agausmann/riemann-kb/README.md

# Riemann

SN1

## Features

- 60% ortholinear
- "Pseudo-split", 3-column separation between halves
- 2x 7-segment indication with external constant-current LED driver and PWM
  dimming
- 3D-printed and laser-cut case files available

## Compatibility

- MX switches (no hotswap)
- (Optional) EC11 encoders in top-left and top-right corners
- Through-hole and SMD component footprints
- Runs on Raspberry Pi Pico (and my USB-C clone, [Piccolo])

[Piccolo]: https://github.com/agausmann/piccolo
