agausmann/riemann-kb/(threads)

Thread 1 (2022-10-30):

LEDs go to full brightness when MCU is reset.

agausmann, 2022-10-30:
This is because the nOE pin of the MAX6969 LED driver is floating on reset (may be internally pulled down by the IC). Adding a pull-up resistor to that pin should fix the issue.
