agausmann/riemann-kb/pcb/encoder_key.kicad_sch

## KiCad design pcb/encoder_key.kicad_sch (2023-07-13)

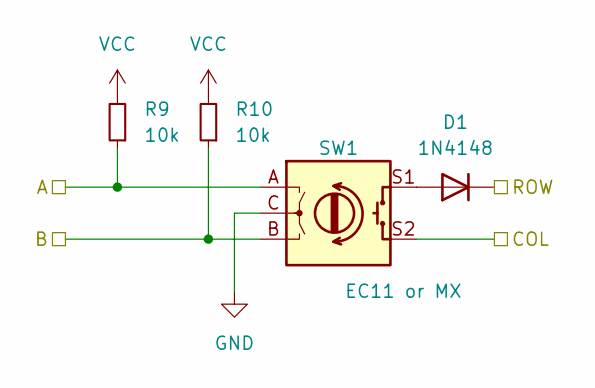
[picture p1: schematic encoder_key.kicad_sch]

Parts:
D1: 1N4148; D_DO-34_SOD68_P7.62mm_Horizontal
R9, R10: 10k; R_Axial_DIN0204_L3.6mm_D1.6mm_P7.62mm_Horizontal
SW1: EC11 or MX; Hybrid_EC11_or_MX

Connections:
A: R9.1, SW1.A
B: R10.1, SW1.B
COL: SW1.S2
GND: SW1.C
unnamed: D1.2 (A), SW1.S1
ROW: D1.1 (K)
VCC: R9.2, R10.2
