agausmann/riemann-kb/pcb/key.kicad_sch

## KiCad design pcb/key.kicad_sch (2023-07-13)

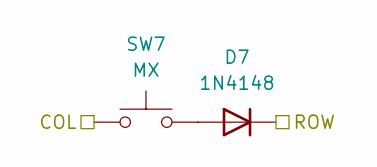
[picture p2: schematic key.kicad_sch]

Parts:
D7: 1N4148; D_DO-34_SOD68_P7.62mm_Horizontal
SW7: MX; SW_Cherry_MX_1.00u_PCB_ReCenter

Connections:
COL: SW7.2
unnamed: D7.2 (A), SW7.1
ROW: D7.1 (K)
