agausmann/riemann-kb/pcb/leds.kicad_sch

## KiCad design pcb/leds.kicad_sch (2023-07-13)

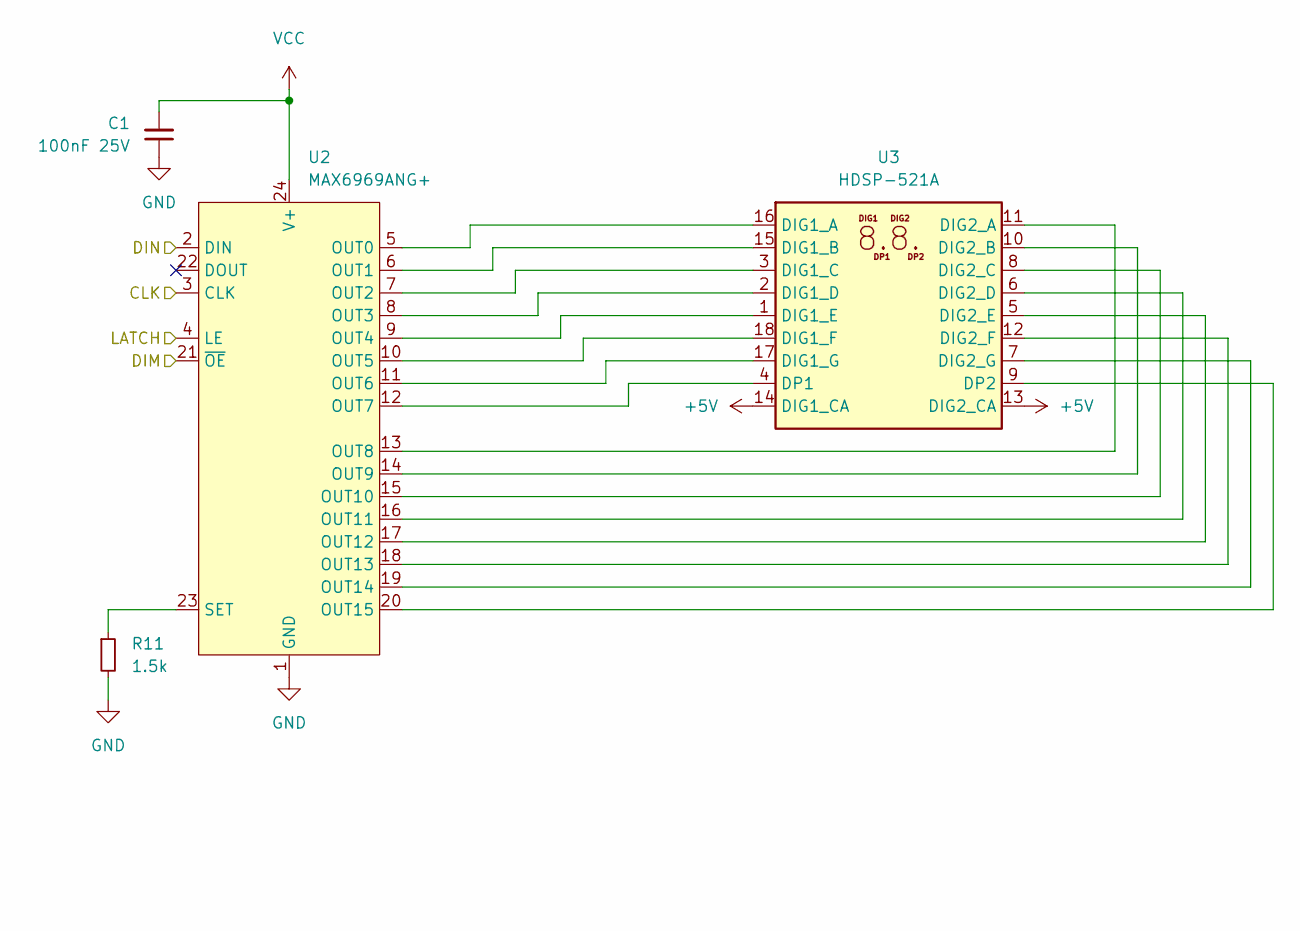
[picture p3: schematic leds.kicad_sch]

Parts:
C1: 100nF 25V; C_Disc_D5.0mm_W2.5mm_P2.50mm
R11: 1.5k; R_Axial_DIN0204_L3.6mm_D1.6mm_P7.62mm_Horizontal
U2: MAX6969ANG+; DIP-24_W7.62mm
U3: HDSP-521A; DA56-11SURKWA

Connections:
+5V: U3.13 (DIG2_CA), U3.14 (DIG1_CA)
CLK: U2.3 (CLK)
DIM: U2.21 (~OE)
DIN: U2.2 (DIN)
GND: C1.1, R11.2, U2.1 (GND)
LATCH: U2.4 (LE)
unnamed: R11.1, U2.23 (SET)
unnamed: U2.5 (OUT0), U3.16 (DIG1_A)
unnamed: U2.6 (OUT1), U3.15 (DIG1_B)
unnamed: U2.7 (OUT2), U3.3 (DIG1_C)
unnamed: U2.8 (OUT3), U3.2 (DIG1_D)
unnamed: U2.9 (OUT4), U3.1 (DIG1_E)
unnamed: U2.10 (OUT5), U3.18 (DIG1_F)
unnamed: U2.11 (OUT6), U3.17 (DIG1_G)
unnamed: U2.12 (OUT7), U3.4 (DP1)
unnamed: U2.13 (OUT8), U3.11 (DIG2_A)
unnamed: U2.14 (OUT9), U3.10 (DIG2_B)
unnamed: U2.15 (OUT10), U3.8 (DIG2_C)
unnamed: U2.16 (OUT11), U3.6 (DIG2_D)
unnamed: U2.17 (OUT12), U3.5 (DIG2_E)
unnamed: U2.18 (OUT13), U3.12 (DIG2_F)
unnamed: U2.19 (OUT14), U3.7 (DIG2_G)
unnamed: U2.20 (OUT15), U3.9 (DP2)
VCC: C1.2, U2.24 (V+)
