agausmann/riemann-kb/pcb/matrix.kicad_sch

## KiCad design pcb/matrix.kicad_sch (2023-07-13)

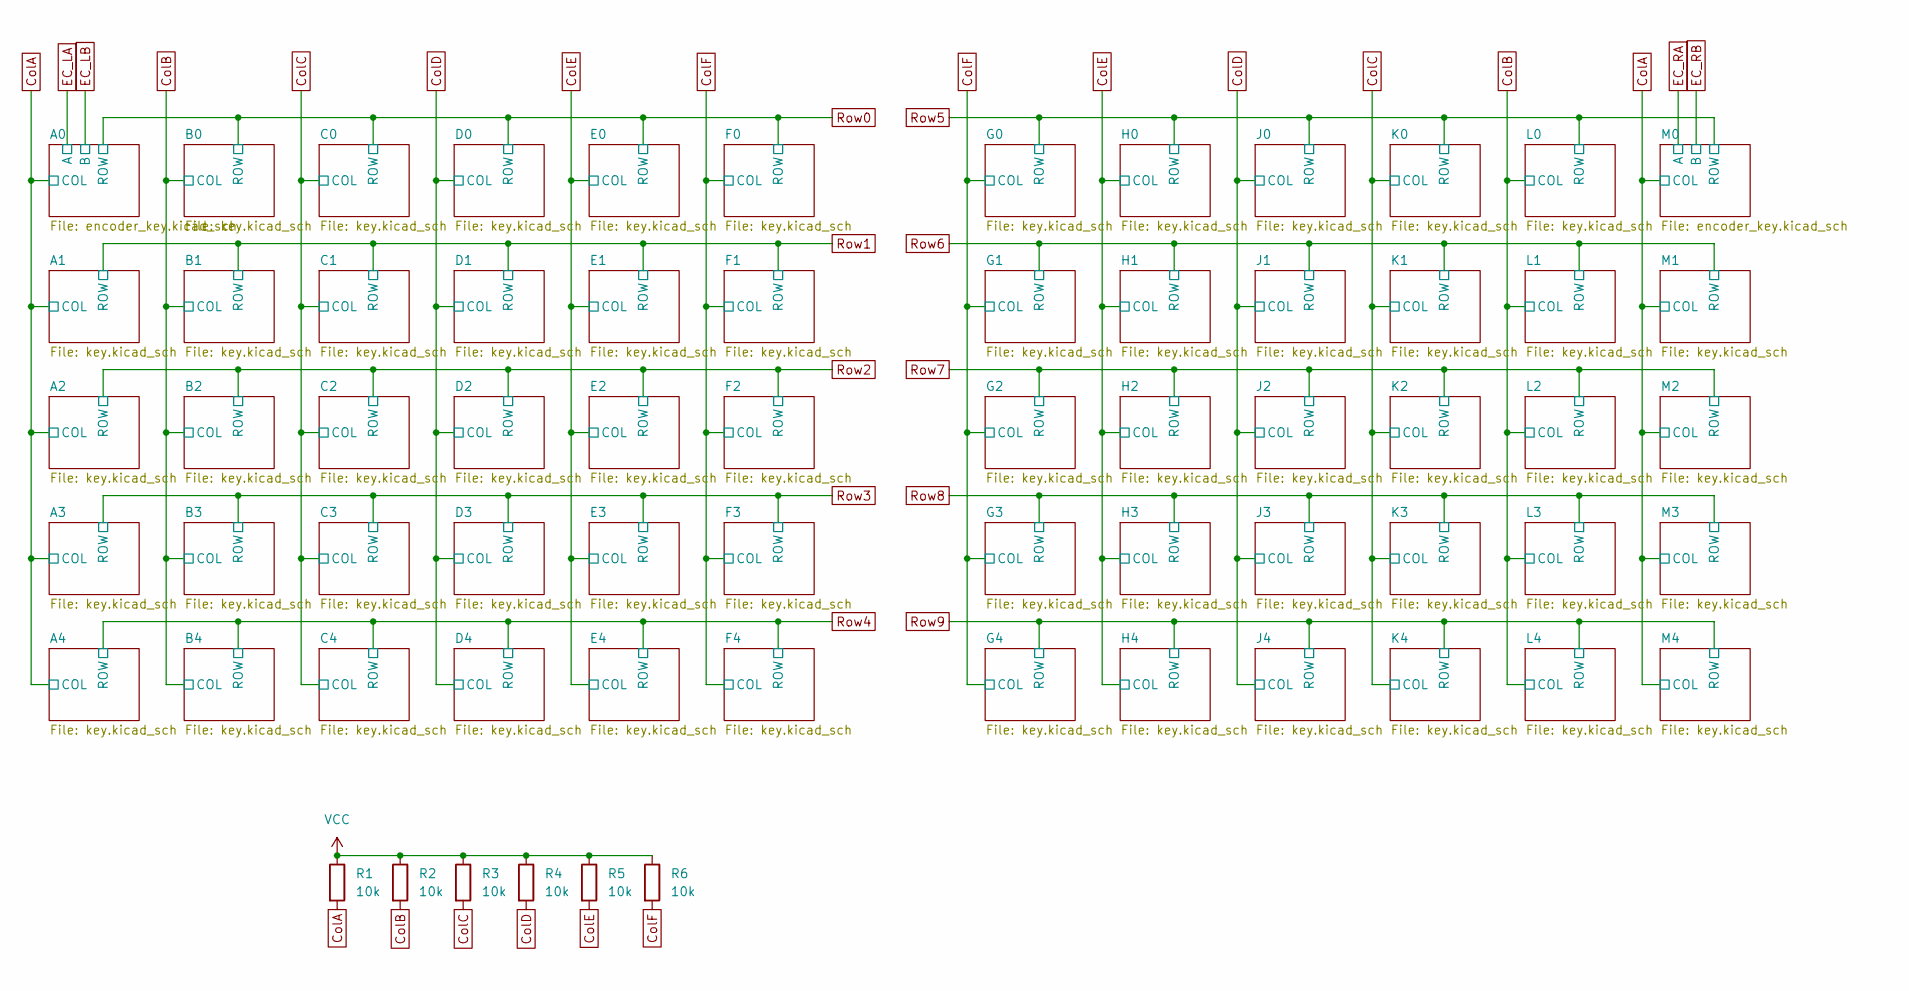
[picture p4: schematic matrix.kicad_sch]

Parts:
R1, R2, R3, R4, R5, R6: 10k; R_Axial_DIN0204_L3.6mm_D1.6mm_P7.62mm_Horizontal

Connections:
ColA: R1.2
ColB: R2.2
ColC: R3.2
ColD: R4.2
ColE: R5.2
ColF: R6.2
VCC: R1.1, R2.1, R3.1, R4.1, R5.1, R6.1
