agausmann/riemann-kb/pcb/riemann.kicad_sch

## KiCad design pcb/riemann.kicad_sch (2023-07-13)

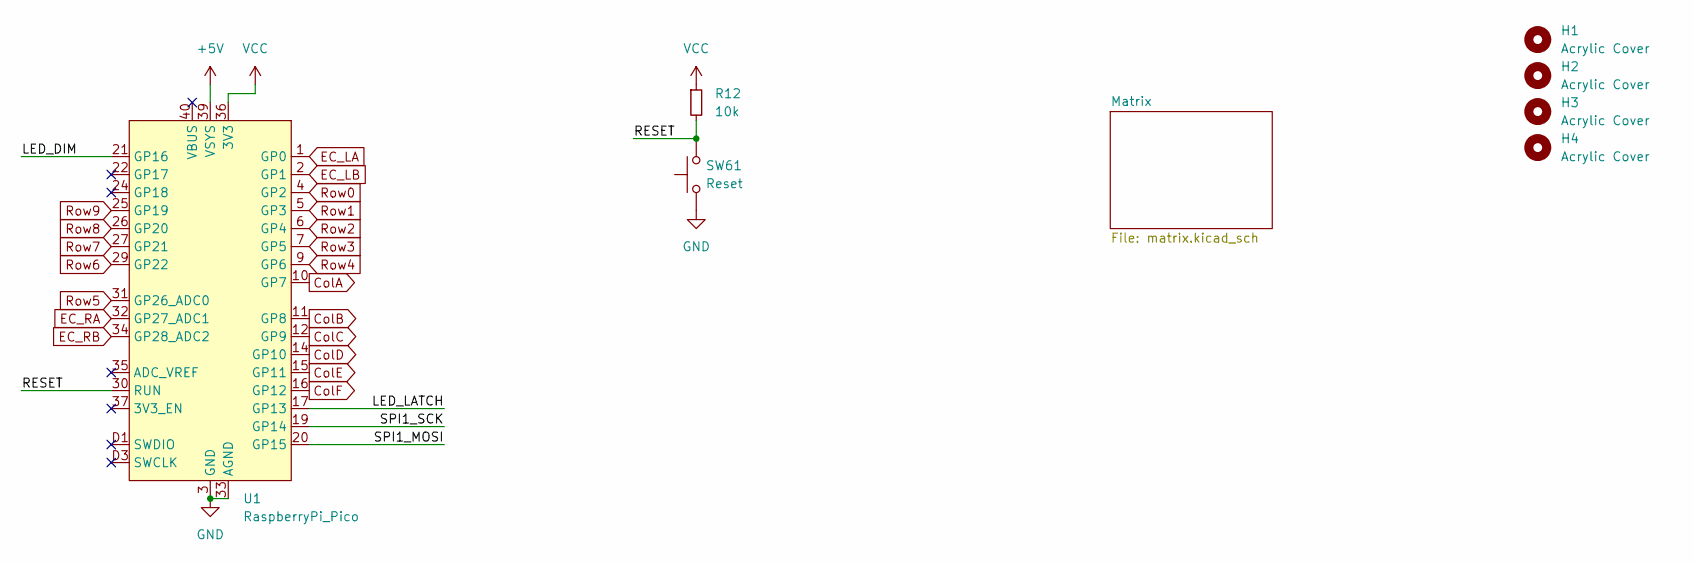
[picture p5: schematic riemann.kicad_sch]

Parts:
H1, H2, H3, H4: Acrylic Cover; MountingHole_2.2mm_M2_Pad
R12: 10k; R_Axial_DIN0204_L3.6mm_D1.6mm_P7.62mm_Horizontal
SW61: Reset; SW_Push_MJTP1117
U1: RaspberryPi_Pico

Connections:
+5V: U1.39 (VSYS)
ColA: U1.10 (GP7)
ColB: U1.11 (GP8)
ColC: U1.12 (GP9)
ColD: U1.14 (GP10)
ColE: U1.15 (GP11)
ColF: U1.16 (GP12)
EC_LA: U1.1 (GP0)
EC_LB: U1.2 (GP1)
EC_RA: U1.32 (GP27_ADC1)
EC_RB: U1.34 (GP28_ADC2)
GND: SW61.2, U1.3 (GND), U1.8 (GND), U1.13 (GND), U1.18 (GND), U1.23 (GND), U1.28 (GND), U1.33 (AGND), U1.38 (GND), U1.D2 (GND)
LED_DIM: U1.21 (GP16)
LED_LATCH: U1.17 (GP13)
RESET: R12.2, SW61.1, U1.30 (RUN)
Row0: U1.4 (GP2)
Row1: U1.5 (GP3)
Row2: U1.6 (GP4)
Row3: U1.7 (GP5)
Row4: U1.9 (GP6)
Row5: U1.31 (GP26_ADC0)
Row6: U1.29 (GP22)
Row7: U1.27 (GP21)
Row8: U1.26 (GP20)
Row9: U1.25 (GP19)
SPI1_MOSI: U1.20 (GP15)
SPI1_SCK: U1.19 (GP14)
VCC: R12.1, U1.36 (3V3)
