agausmann/riemann-kb/(commit log)

2022-08-27 Add PCB and case design
    [bottom_plate.scad, center_cover.scad, encoder_key.kicad_sch, full_assembly.scad, key.kicad_sch, leds.kicad_sch, matrix.kicad_sch, mounting.scad]
2022-08-27 PCB final touches before order
2022-08-27 Remove debug port pads from Pico footprint
    Its location is inconsistent (changed in the Pico W)
2022-08-27 Fix silkscreen legend orientation
2022-09-04 Configure pins for matrix and encoders
2022-09-10 FW: Implement keymap, pin matrix and USB connectivity
2022-09-11 FW: Refactor main loop state into a struct, use timer for periodic tasks
2022-09-11 FW: Put device to sleep between tasks instead of busy waiting
2022-09-11 Add encoders stubs and caps LED, decrease matrix polling rate
2022-09-11 Add a simple 2-sample debounce
    Key state only changes if the key is read
    in the same state in 2 consecutive samples.
2022-09-12 Add encoder drivers
2022-09-13 Add keys per second indication, dim LEDs a bit
2022-09-15 Shutoff LEDs when USB bus is disconnected
    Seems to be the most reliable way to detect when
    the host is powered off, if USB devices still have power.
2022-09-22 Gracefully handle most error cases instead of panicking
    [main.rs]
2022-10-30 Reset task timers after keyboard wakes up.
    Encountered some interesting bugs after
    sleep/wake where the LED display
    wouldn't respond and there were more
    bounces than usual, I think it has to do
    with timers running too quickly after
    wake.
    [main.rs]
2022-11-01 Factor out encoder/usb modules
2022-11-01 Avoid using MaybeUninit, use Option instead.
    [usb.rs]
2022-11-20 Fix ordering of double digits
    [digit.rs]
2022-12-04 Make sure key is still released before handling release event.
    There seems to be issues with bounces on the downstroke causing a "release" event.
    To mitigate this, check that the key is still released after being deferred.
    [main.rs]
2023-03-30 Add top and middle shell case parts
    [middle_shell.scad, mounting.scad, top_shell.scad, vars.scad]
2023-03-30 Add case assembly model
    [case_assembly.scad, plate_assembly.scad]
2023-04-04 Finalized case design
    After many tweaks that I forgot to track
    [bottom_shell.scad, case_assembly.scad, front_cover.scad, middle_shell.scad, mounting.scad, rear_cover_piccolo.scad, top_shell.scad, vars.scad]
2023-06-22 Switch to usbd-human-interface-device
2023-06-22 Fix missing tick for USB HID
    [main.rs, usb.rs]
2023-06-22 Fix panic in boot keys handler
    [report.rs]
2023-06-22 Reset to bootloader on panic
    [main.rs]
2023-06-22 Add volume control with encoders and queued keys
2023-06-22 Replace fullhouse with heapless::Deque
    [debounce.rs, main.rs]
2023-07-13 Increase polling frequency of NKRO report
    [encoder_key.kicad_sch, key.kicad_sch, leds.kicad_sch, matrix.kicad_sch, riemann.kicad_sch]
2023-07-13 USB PID assigned by pid.codes
